dk-1983/4VRS-Display/assets/media/server-rack/README.txt

4VRS personal server rack animation.

4vrs-server-rack-240x320.gif: 240x320, 24 frames, 180ms encoded frame delay,
69318 bytes, infinite loop. Only tiny decorative front-panel LEDs animate;
rack, cables, title and flat background remain fixed. No live telemetry is
represented by this artwork. At most 15 display rows change between frames.
Rebuild with Pillow: python tools/package_rack_animation.py

Static artwork generated with built-in image_gen from the user's server rack
photograph. Prompt: isolate the actual silver cabinet, preserve patch cables,
panels, four compact servers and APC UPS arrangement; remove room, brick wall,
radiator and open glass door; straighten front view; solid dark navy background;
add metallic cyan 4VRS title above; no new equipment or extra text.
rack-original.png preserves generated source; rack-preview.png is first frame.
