dk-1983/4VRS-Display/hardware/schematic/4vrs-display-schematic-A2.pdf

4VRS DISPLAY | Power, controller and display

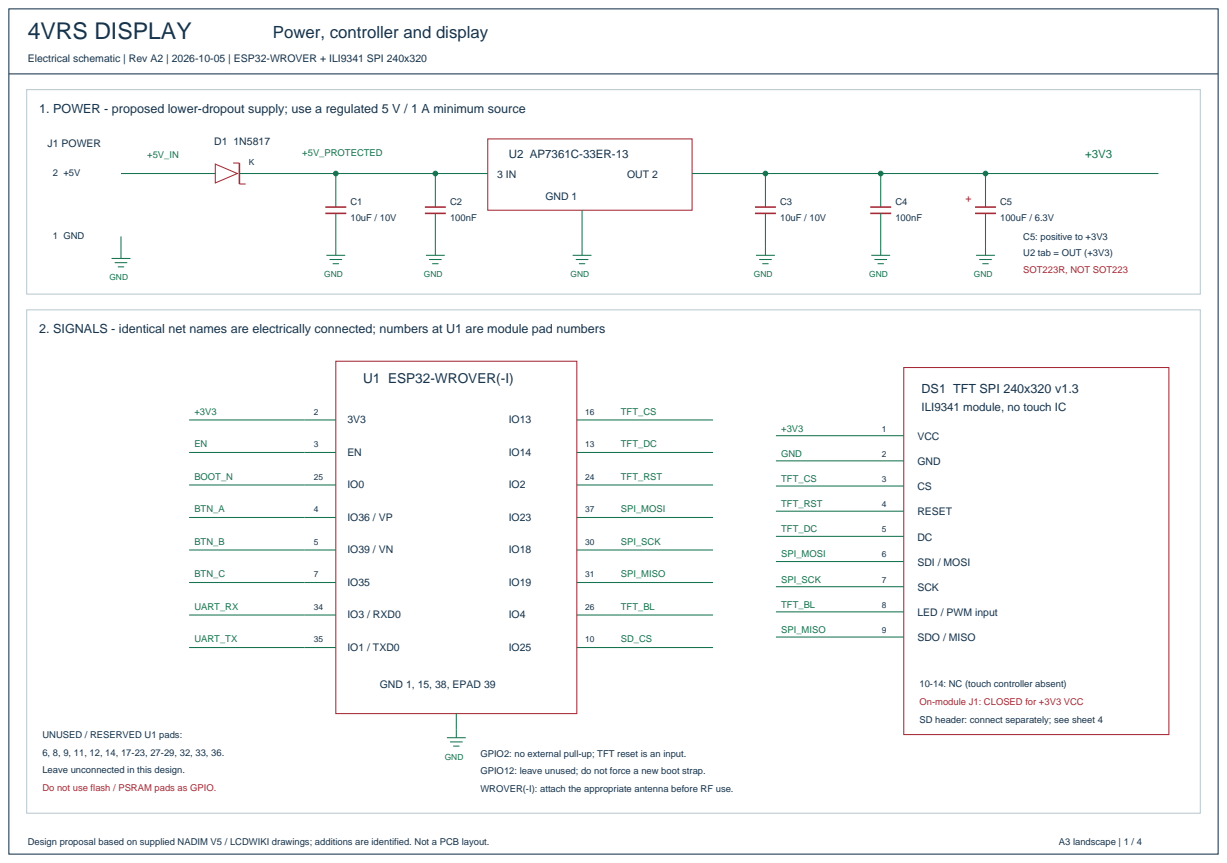
[picture p2: page 1]

Electrical schematic | Rev A2 | 2026-10-05 | ESP32-WROVER + ILI9341 SPI 240x320

1. POWER - proposed lower-dropout supply; use a regulated 5 V / 1 A minimum source

2. SIGNALS - identical net names are electrically connected; numbers at U1 are module pad numbers

DS1 TFT SPI 240x320 v1.3
ILI9341 module, no touch IC

10-14: NC (touch controller absent)
On-module J1: CLOSED for +3V3 VCC
SD header: connect separately; see sheet 4

UNUSED / RESERVED U1 pads:
Leave unconnected in this design.
Do not use flash / PSRAM pads as GPIO.

GPIO2: no external pull-up; TFT reset is an input.
GPIO12: leave unused; do not force a new boot strap.
WROVER(-I): attach the appropriate antenna before RF use.

4VRS DISPLAY | Reset, service connector and backlight

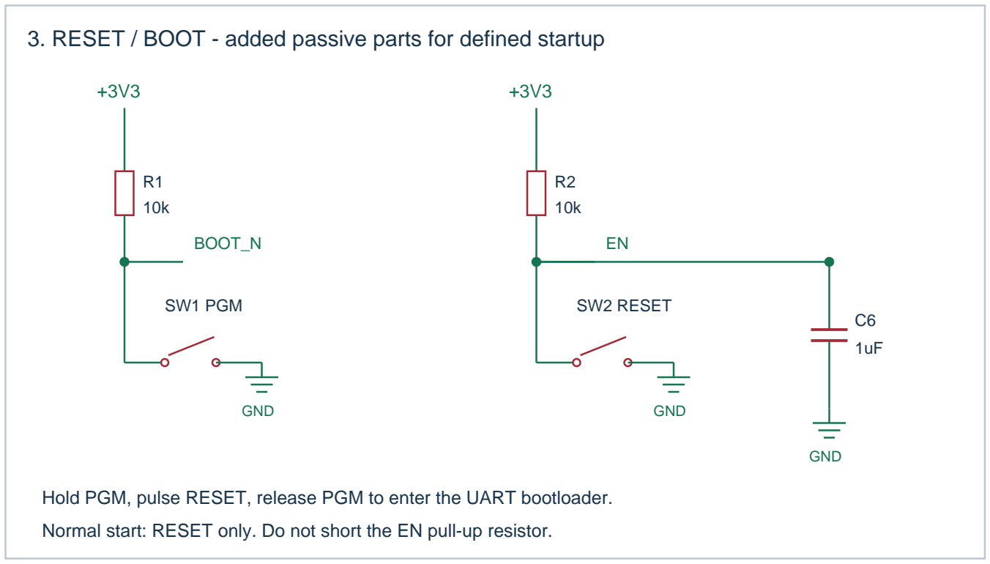
[picture p3: figure]
BOOT_N; SW1 PGM; GND; SW2 RESET

Design proposal based on supplied NADIM V5 / LCDWIKI drawings; additions are identified. Not a PCB layout. | A3 landscape | 2 / 4

### 3. RESET / BOOT - added passive parts for defined startup

Hold PGM, pulse RESET, release PGM to enter the UART bootloader. Normal start: RESET only. Do not short the EN pull-up resistor.

### 4. UART SERVICE - 3.3 V logic, manual reset

### J2 / P10 UART

1

GND
Adapter GND

2

UART_RX
From adapter TX output

3

UART_TX
To adapter RX input

Power the device through J1; do not join two supply outputs. Signal direction is authoritative: adapter connector labels may vary. UART log: 115200 baud. GPIO1 = ESP TX; GPIO3 = ESP RX.

### 5. OUR MODULE - direct GPIO4 to display LED pin

## U1 ESP32

GPIO4 / pad 26

## DS1 ILI9341

8 LED / PWM

TFT_BL

Actual wiring: GPIO4 connects directly to DS1 pin 8 (LED). No external transistor or series resistor in this connection. Module internal backlight circuitry is not expanded here. Firmware PWM: 5 kHz / 10 bit. HIGH enables backlight.

Optional R3: PWM low at reset.

R3
100k
TFT_BL

GND

### 6. ALTERNATIVE ONLY - display with separate LEDA / LEDK

GPIO4

R20
1k

GND

Q20 MMBT2222A

B=1, E=2, C=3

R21
see calculation
LEDK

R22
100k

GND
LEDA -> rated supply; LEDK -> R21 -> Q20 collector. Example: one 3.0 V LED string, 3.3 V supply, 10 mA target. R21 >= (3.3 - 3.0 - 0.1) / 0.010 = 20 ohm; choose 22 ohm. Recalculate for actual Vf, current and supply tolerances. Parallel strings need individual limiting or a LED driver.
Not for our DS1 LED input. Do not connect both circuits.

R20 limits GPIO/base current; the original drawing omitted it.

4VRS DISPLAY | Assembly notes, options and component list

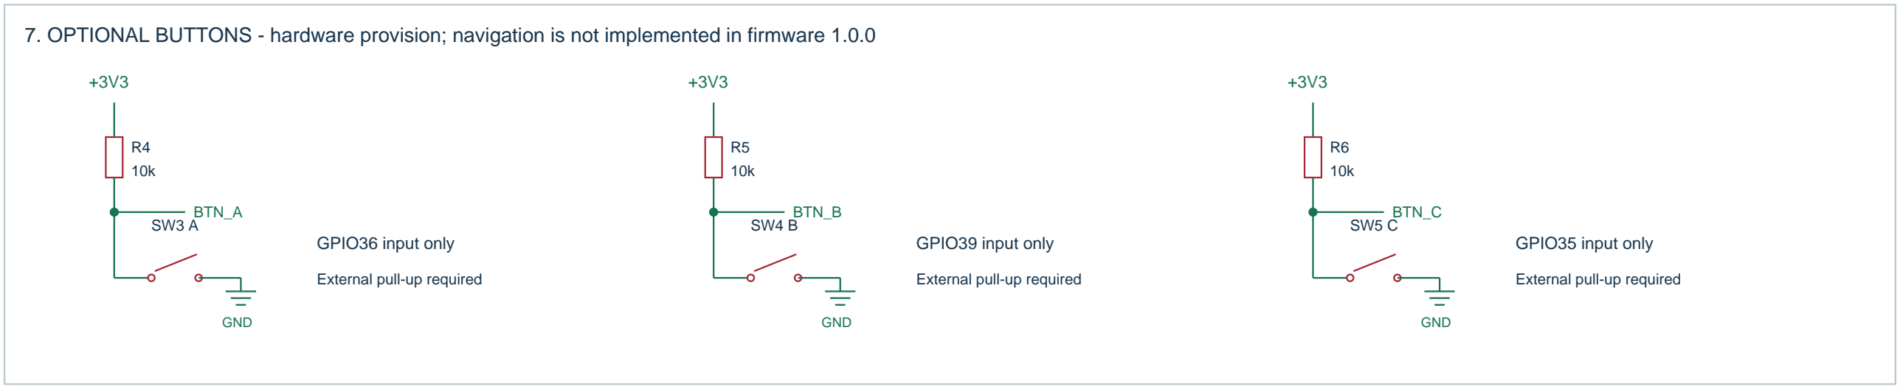
[picture p4: figure]
BTN_A SW3 A; GND; GPIO36 input only; External pull-up required; BTN_B SW4 B; GPIO39 input only; BTN_C SW5 C; GPIO35 input only

Design proposal based on supplied NADIM V5 / LCDWIKI drawings; additions are identified. Not a PCB layout. | A3 landscape | 3 / 4

### 7. OPTIONAL BUTTONS - hardware provision; navigation is not implemented in firmware 1.0.0

### 8. MAIN ASSEMBLY BOM

U1 | ESP32-WROVER(-I), PSRAM, module
U2 | AP7361C-33ER-13, 3.3 V, SOT223R
D1 | 1N5817, series reverse-polarity diode
J1 / J2 | 2-pin power / 3-pin UART connector
DS1 | TFT SPI ILI9341 240x320, LED logic input
C1 / C3 | 10uF X7R, 10 V; effective C >= 4.7uF
C2 / C4 | 100nF X7R, 10 V or higher
C5 | 100uF electrolytic, >= 6.3 V
C6 | 1uF X7R, >= 6.3 V
R1 / R2 | 10k, 1%, 0.1 W or higher
R3 | 100k, 1%, optional PWM pull-down
SW1 / SW2 | Normally-open momentary PGM / RESET
R4-R6 / SW3-SW5 | Optional: 10k / normally-open buttons

Q20 / R20-R22 belong only to the alternative, not the main BOM.

### 9. BUILD CONDITIONS AND REFERENCES

U2 is a proposed change from the original L1117-33 supply. Check the exact SOT223R package: 1=GND, 2/tab=OUT, 3=IN. Ordinary SOT223 AP7361C has a different pinout.
Place C1/C2 close to U2 IN; C3 close to U2 OUT.
Place C4/C5 close to U1 power pins with a short ground return. Allow at least 500 mA for ESP32 plus LCD/backlight current. LDO heat: P=(Vin-3.3)*I; 4.7 V at 0.5 A gives about 0.7 W. Provide copper area and check temperature inside the enclosure. For sustained high load, use a qualified 3.3 V buck supply.
DS1 VCC=3.3 V: close its supply jumper J1 (0R bypass).
If changing DS1 VCC to 5 V, open its J1 first.
Touch pins are NC; SD uses SPI + GPIO25 (sheet 4).
GPIO numbers are not ESP32 chip QFN pad numbers.
No ERC/SPICE or new PCB hardware validation has been run. Confirm supply, startup and current on the assembled hardware.

Manufacturer documentation (clickable in PDF):

LCDWIKI MSP2402: module schematic and manual (https://www.lcdwiki.com/2.4inch_SPI_Module_ILI9341_SKU:MSP2402) Espressif: WROVER module / hardware design guidelines (https://docs.espressif.com/projects/esp-hardware-design-guidelines/en/latest/esp32/schematic-checklist.html) Diodes: AP7361C datasheet; original 1117: see TI datasheet (https://www.diodes.com/datasheet/download/AP7361C.pdf)

4VRS DISPLAY | Shared SPI bus and SD memory card

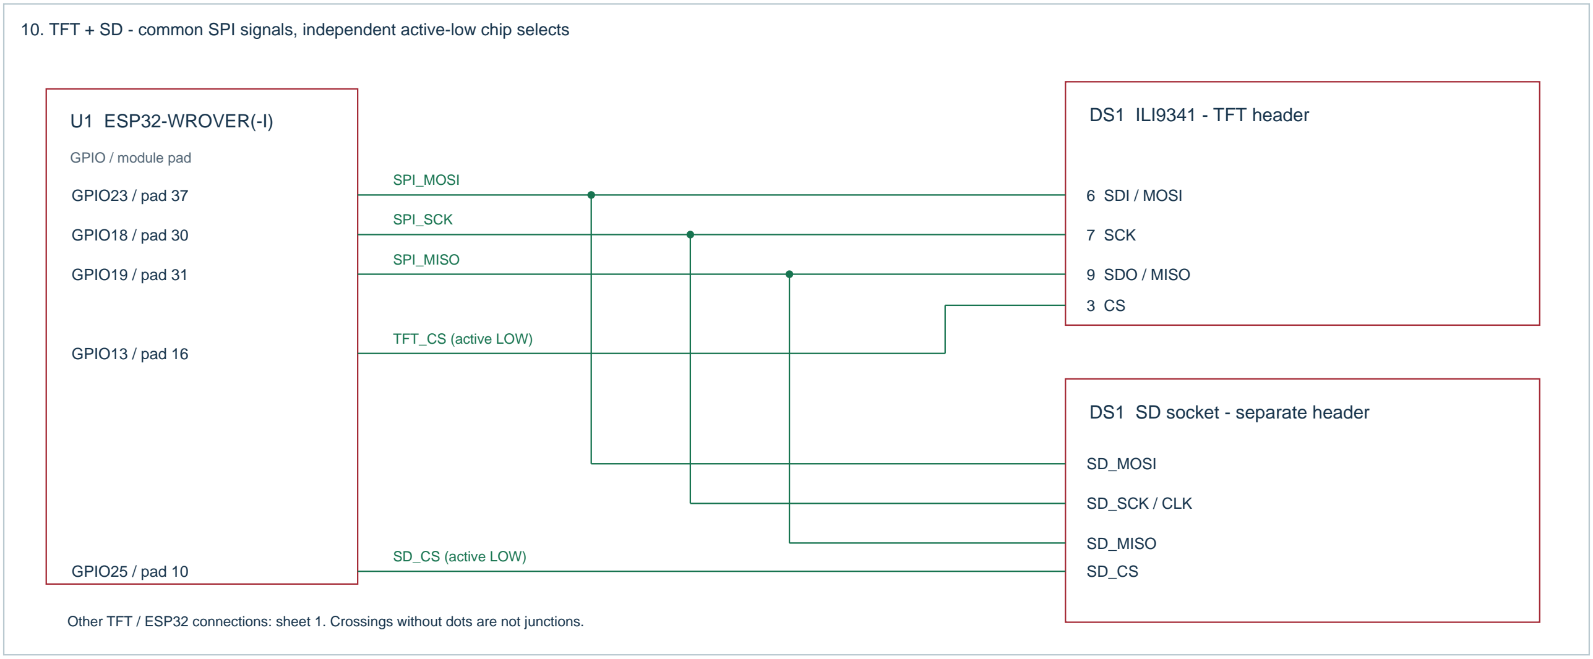
[picture p5: figure]
U1 ESP32-WROVER(-I); GPIO / module pad; DS1 ILI9341 - TFT header; DS1 SD socket - separate header; GPIO23 / pad 37; SPI_MOSI; 6 SDI / MOSI; SD_MOSI; GPIO18 / pad 30; SPI_SCK; 7 SCK; SD_SCK / CLK; GPIO19 / pad 31; SPI_MISO; 9 SDO / MISO; SD_MISO; GPIO13 / pad 16; TFT_CS (active LOW); GPIO25 / pad 10; SD_CS (active LOW)

Design proposal based on supplied NADIM V5 / LCDWIKI drawings; additions are identified. Not a PCB layout. | A3 landscape | 4 / 4

### 10. TFT + SD - common SPI signals, independent active-low chip selects

Other TFT / ESP32 connections: sheet 1. Crossings without dots are not junctions.

### 11. ASSEMBLY - existing SD socket on our LCDWIKI display module

Wire all FOUR SD header signals; the module does not internally connect them to the TFT SPI header. SD header contacts are identified by their silkscreen names; no unverified header pin order is implied. TFT_CS = GPIO13. SD_CS = GPIO25 (U1 module pad 10). Do not connect the two CS signals together. SD socket power and ground are internal to DS1; retain the module VCC/GND connection from sheet 1. All logic is 3.3 V. Keep SPI leads short. MISO is required for SD even without TFT readback diagnostics. Firmware 1.0.0 uses a shared SPI bus, MISO pull-up and separate CS handling; SD starts at 1 MHz. Use a FAT32 card; 16 GB microSD with a full-size SD adapter has been tested. No automatic formatting. This sheet shows the existing module socket, not a wiring diagram for an arbitrary bare SD socket.
