dk-1983/4VRS-Display/docs/README.md

# Документация 4VRS Display

- [Первый запуск и web-настройки](user-guide.md)
- [Оборудование и диагностика дисплея](hardware.md)
- [Home Assistant и карточки](home-assistant.md)
- [Обновление прошивки](updates.md)
- [Сборка и тестирование](development.md)
- [План развития](plan.md)
- [MQTT-протокол](../protocol/README.md)

Эти инструкции описывают firmware 1.0.0 и интеграцию Home Assistant 0.4.3.
