dk-1983/4VRS-Display/home_assistant/README.md

# Интеграция Home Assistant 0.4.3

[Установка, сопряжение и выбор сущностей](../docs/home-assistant.md).

Исходный компонент: `custom_components/fourvrs_display`. При обновлении сохраняйте
существующее сопряжение и перезапускайте HA после замены файлов.
