dk-1983/4VRS-Display/protocol/examples/README.md

# Примеры MQTT

JSON-файлы содержат вымышленные ключи и идентификаторы для проверки протокола.
Используйте собственный ключ и актуальную сессию при работе с устройством.
