dk-1983/4VRS-Display/protocol/schemas/README.md

# JSON Schema

Схемы описывают форматы сообщений MQTT. Дополнительные ограничения UTF-8 в байтах
помечены `x-maxUtf8Bytes` и проверяются реализациями отдельно от JSON Schema.
