dk-1983/4VRS-Display/assets/media/tux/README.txt

Tux / intel inside decorative animation for 4VRS Display.

tux-intel-inside-240x320.gif: 240x320, looping, 24348 bytes.
Static body and flat dark background; small blinking-eye and badge-glint layers.
Rebuild with Pillow: python tools/package_tux_animation.py

Static artwork generated with built-in image_gen. Prompt: friendly recognizable
Tux penguin, front-facing, white belly, yellow beak/feet, clear oval eyes;
cyan classic oval badge reading exactly "intel inside" above; solid dark navy
background, no other text or objects, composition suitable for a small display.
Original and first-frame preview are preserved alongside the GIF.

Third-party names and marks belong to their respective owners. Decorative
artwork does not imply endorsement or describe the ESP32's processor vendor.
The project MIT license does not grant rights to third-party trademarks.
