dk-1983/4VRS-Display/docs/plan.md

# Roadmap / План развития

Firmware 1.0.0 includes MQTT room cards, web settings, signed OTA, FAT32 SD photo/GIF playback, browser media uploads and per-file slideshow timing. Home Assistant integration 0.4.3 supports optional entities, brightness and MAC diagnostics.

Next steps: HA-side media management, richer playlists, local sensors and physical-button navigation. Video/audio are not implemented. Scope and hardware support will be agreed before development.

В 1.0.0 реализованы MQTT-карточки по помещениям, web-настройки, подписанные OTA, фото/GIF с FAT32 SD, загрузка из браузера и индивидуальное время файлов в слайд-шоу. Интеграция HA 0.4.3 поддерживает сопряжение без сущностей, яркость и диагностику MAC.

Далее: управление медиа из HA, расширенные плейлисты, локальные датчики и физические кнопки. Видео и звук не реализованы. Объём работы и поддерживаемое оборудование согласуются перед разработкой.
