dk-1983/4VRS-Display/assets/demo-240x320.bmp

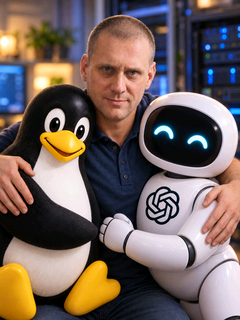
assets/demo-240x320.bmp
