dk-1983/4VRS-Display/assets/demo-source.png

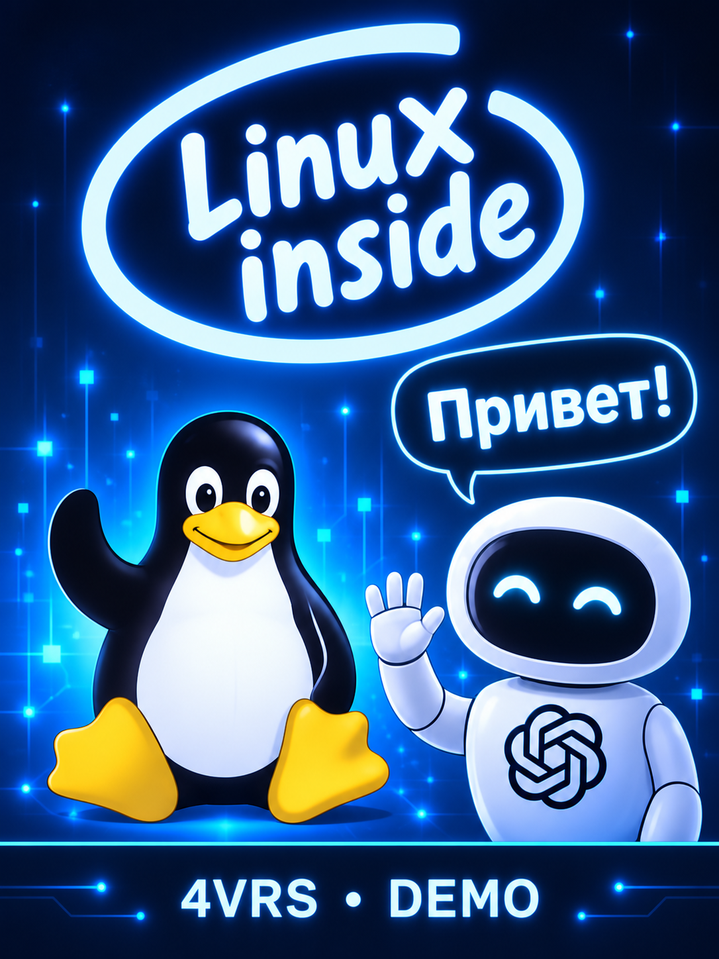
assets/demo-source.png
