dk-1983/4VRS-Display/assets/media/bolid/bolid-240x320.gif

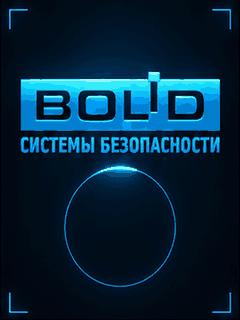
assets/media/bolid/bolid-240x320.gif
