dk-1983/4VRS-Display/assets/media/bolid/bolid-flat-original.png

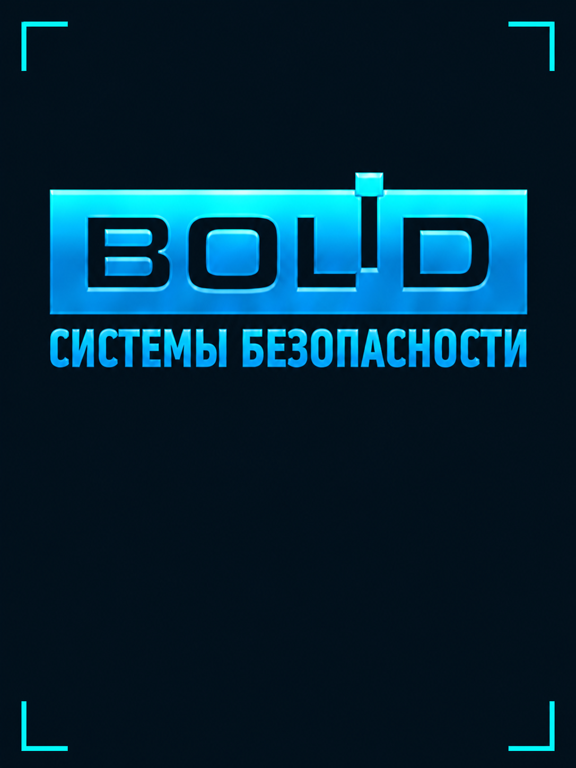
assets/media/bolid/bolid-flat-original.png
