dk-1983/4VRS-Display/assets/media/bolid/bolid-frames-original.png

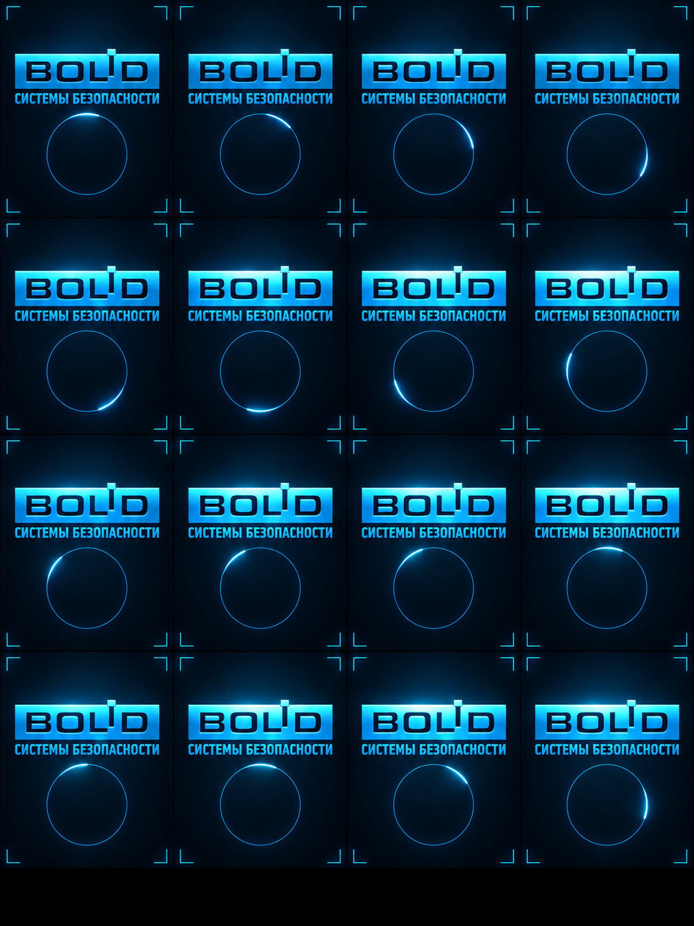
assets/media/bolid/bolid-frames-original.png
