dk-1983/4VRS-Display/assets/media/bolid/bolid-s2000-kpb-240x320.gif

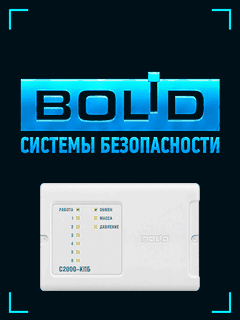
assets/media/bolid/bolid-s2000-kpb-240x320.gif
