dk-1983/4VRS-Display/assets/media/bolid/bolid-static-original.png

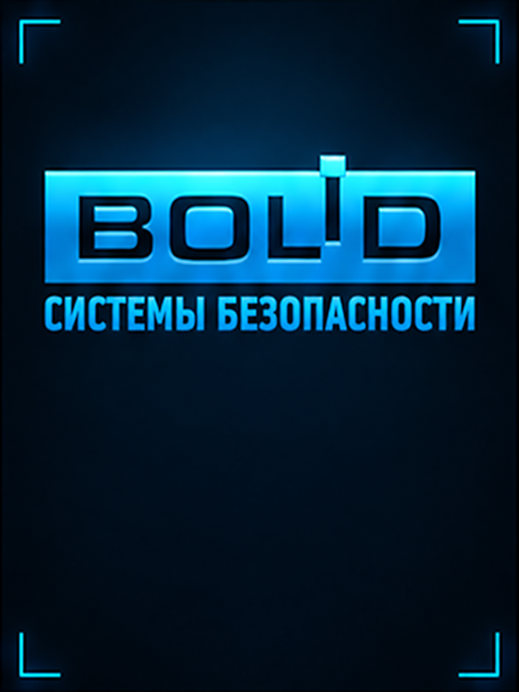
assets/media/bolid/bolid-static-original.png
