dk-1983/4VRS-Display/assets/media/bolid/s2000-kpb-cutout.png

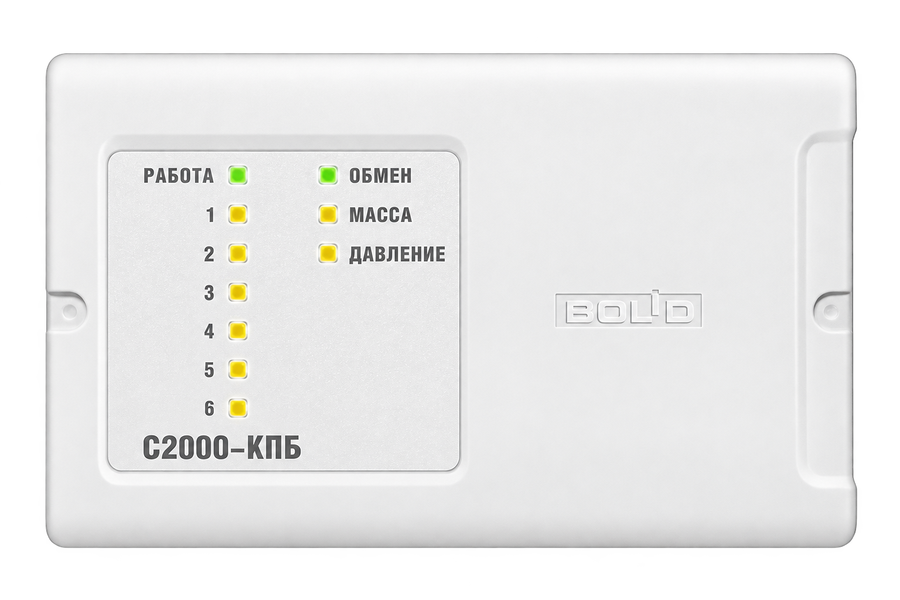
assets/media/bolid/s2000-kpb-cutout.png
