dk-1983/4VRS-Display/assets/media/companion/companion-240x320.gif

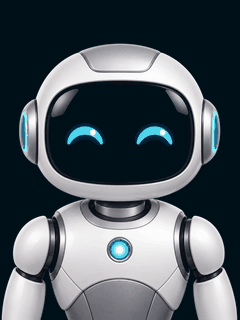
assets/media/companion/companion-240x320.gif
