dk-1983/4VRS-Display/assets/media/server-rack/4vrs-server-rack-240x320.gif

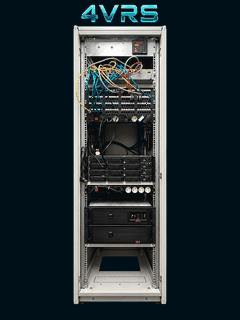
assets/media/server-rack/4vrs-server-rack-240x320.gif
