dk-1983/4VRS-Display/assets/media/tux/tux-intel-inside-240x320.gif

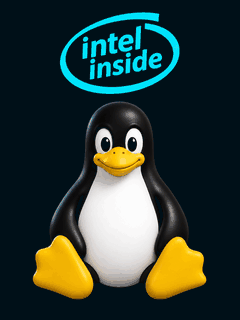
assets/media/tux/tux-intel-inside-240x320.gif
