dk-1983/4VRS-Display/home_assistant/tests/README.md

# Тесты интеграции

Запуск из корня проекта:

```sh
python -m unittest discover -s home_assistant/tests -v
```

Проверяются сопряжение, состояния, помещения, выбор сущностей и политика обновлений.
