dk-1983/4VRS-Display/assets/test/4vrs-test.gif

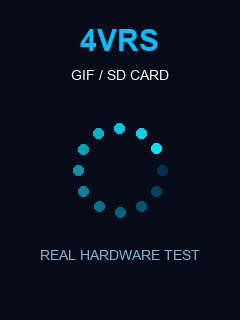
assets/test/4vrs-test.gif
