dk-1983/4VRS-Display/firmware/rack_bootstrap/MqttProtocol.h

#pragma once
#include <Arduino.h>
#include <cJSON.h>
#include <math.h>

namespace RackMqtt {
constexpr size_t MAX_PAYLOAD = 15360;
constexpr unsigned MAX_CARDS = 20;
struct Card { char id[97]{}, name[97]{}, kind[17]{}, state[97]{}, unit[17]{}, icon[17]{}, area[49]{}, areaIcon[17]{}; bool alert=false, hasArea=false; };
struct Snapshot { Card cards[MAX_CARDS]; unsigned count=0; uint32_t seq=0, ttl=90, received=0; bool valid=false; };

inline bool textField(const cJSON *obj, const char *key, char *out, size_t size, bool empty=false) {
  const cJSON *v=cJSON_GetObjectItemCaseSensitive(obj,key);
  if(!cJSON_IsString(v) || !v->valuestring) return false;
  const char *s=v->valuestring; size_t n=strlen(s);
  if(n>=size || (!empty && !n)) return false;
  // Reject controls and malformed UTF-8 before passing text to the renderer.
  for(size_t i=0;i<n;) {
    uint8_t a=(uint8_t)s[i++];
    if(a<32 || a==127) return false;
    if(a<128) continue;
    unsigned more; uint32_t cp, minimum;
    if(a>=0xc2 && a<=0xdf) {more=1;cp=a&31;minimum=0x80;}
    else if(a>=0xe0 && a<=0xef) {more=2;cp=a&15;minimum=0x800;}
    else if(a>=0xf0 && a<=0xf4) {more=3;cp=a&7;minimum=0x10000;}
    else return false;
    if(i+more>n) return false;
    while(more--) {uint8_t b=(uint8_t)s[i++];if((b&0xc0)!=0x80)return false;cp=(cp<<6)|(b&63);}
    if(cp<minimum || cp>0x10ffff || (cp>=0xd800 && cp<=0xdfff)) return false;
  }
  memcpy(out,s,n+1); return true;
}
inline bool numberField(const cJSON *obj,const char *key,uint32_t &out,uint32_t lo,uint32_t hi) {
  const cJSON *v=cJSON_GetObjectItemCaseSensitive(obj,key);
  if(!cJSON_IsNumber(v) || !isfinite(v->valuedouble) || v->valuedouble<lo || v->valuedouble>hi || floor(v->valuedouble)!=v->valuedouble) return false;
  out=(uint32_t)v->valuedouble;return true;
}
inline bool uniqueKeys(const cJSON *obj,unsigned depth=0) {
  if(depth>8) return false;
  for(const cJSON *a=obj->child;a;a=a->next) {
    if(cJSON_IsObject(obj)) for(const cJSON *b=a->next;b;b=b->next)
      if(a->string && b->string && !strcmp(a->string,b->string)) return false;
    if((cJSON_IsObject(a)||cJSON_IsArray(a))&&!uniqueKeys(a,depth+1)) return false;
  } return true;
}
inline cJSON *parse(const char *data,size_t length) {
  // cJSON accepts embedded escaped NULs; reject them to prevent truncated keys/text.
  if(!length || length>MAX_PAYLOAD || memchr(data,0,length)) return nullptr;
  for(size_t i=0;i+5<length;i++) if(data[i]=='\\' && !memcmp(data+i+1,"u0000",5)) return nullptr;
  unsigned depth=0;bool quoted=false,escaped=false;
  for(size_t i=0;i<length;i++) {char c=data[i];if(quoted){if(escaped)escaped=false;else if(c=='\\')escaped=true;else if(c=='"')quoted=false;}
    else if(c=='"')quoted=true;else if(c=='{'||c=='['){if(++depth>8)return nullptr;}else if(c=='}'||c==']'){if(!depth)return nullptr;--depth;}}
  if(depth||quoted)return nullptr;
  const char *end=nullptr; cJSON *root=cJSON_ParseWithLengthOpts(data,length,&end,false);
  if(!root)return nullptr;
  while(end<data+length && (*end==' '||*end=='\r'||*end=='\n'||*end=='\t'))++end;
  if(end!=data+length || !cJSON_IsObject(root) || !uniqueKeys(root)){cJSON_Delete(root);return nullptr;}
  return root;
}
inline bool allowedKeys(const cJSON *obj,const char *const *keys,size_t count) {
  for(const cJSON *v=obj->child;v;v=v->next){bool found=false;for(size_t i=0;i<count;i++)if(v->string&&!strcmp(v->string,keys[i]))found=true;if(!found)return false;}return true;
}
inline const char *decodeSnapshot(const cJSON *root,const char *session,uint32_t lastSeq,Snapshot &next) {
  const char *const keys[]={"schema","key","session","seq","ttl_s","cards"};
  if(!allowedKeys(root,keys,6))return "unknown_field";
  uint32_t schema; char incoming[33];
  if(!numberField(root,"schema",schema,1,1))return "schema";
  if(!textField(root,"session",incoming,sizeof(incoming))||strcmp(session,incoming))return "session";
  if(!numberField(root,"seq",next.seq,1,0xffffffffU)||next.seq<=lastSeq)return "sequence";
  if(!numberField(root,"ttl_s",next.ttl,30,300))return "ttl";
  const cJSON *cards=cJSON_GetObjectItemCaseSensitive(root,"cards");
  if(!cJSON_IsArray(cards))return "cards";
  int count=cJSON_GetArraySize(cards);if(count<0||count>MAX_CARDS)return "card_count";
  for(int i=0;i<count;i++) {
    const cJSON *v=cJSON_GetArrayItem(cards,i);const char *const ck[]={"id","name","kind","state","unit","icon","alert","area","area_icon"};
    if(!cJSON_IsObject(v)||!allowedKeys(v,ck,9))return "card";
    Card &c=next.cards[i];
    if(!textField(v,"id",c.id,sizeof(c.id))||!textField(v,"name",c.name,sizeof(c.name))||!textField(v,"kind",c.kind,sizeof(c.kind))||!textField(v,"state",c.state,sizeof(c.state))||!textField(v,"unit",c.unit,sizeof(c.unit),true))return "card_text";
    if(cJSON_HasObjectItem(v,"area")) {
      if(!textField(v,"area",c.area,sizeof(c.area),true))return "area";
      c.hasArea=true;
    }
    if(cJSON_HasObjectItem(v,"area_icon")) {
      if(!c.hasArea||!textField(v,"area_icon",c.areaIcon,sizeof(c.areaIcon)))return "area_icon";
      const char *icons[]={"room","toilet","bathroom","kitchen","bedroom","living","garage","office","server","balcony","hall","garden","laundry","storage","kids"};
      bool known=false;for(const char *i:icons)if(!strcmp(c.areaIcon,i))known=true;
      if(!known)return "area_icon";
    }
    if(cJSON_HasObjectItem(v,"icon")) {
      if(!textField(v,"icon",c.icon,sizeof(c.icon)))return "icon";
      const char *icons[]={"air","battery","binary_sensor","button","camera","clock","door","event","fan","gas","group","humidity","image","leak","light","list","location","lock","media","money","motion","network","person","plug","power","pressure","remote","robot","ruler","sensor","settings","shield","smoke","sound","storage","sun","switch","temperature","text","update","valve","warning","water","weather","wind","window"};
      bool known=false;for(const char *i:icons)if(!strcmp(c.icon,i)){known=true;break;}
      if(!known)return "icon";
    }
    if(cJSON_HasObjectItem(v,"alert")){const cJSON *a=cJSON_GetObjectItemCaseSensitive(v,"alert");if(!cJSON_IsBool(a))return "alert";c.alert=cJSON_IsTrue(a);}
    for(const char *p=c.id;*p;p++)if(!((*p>='a'&&*p<='z')||(*p>='0'&&*p<='9')||*p=='_'||*p=='.'))return "entity_id";
    if(!strchr(c.id,'.'))return "entity_id";
    if(strcmp(c.kind,"fan")&&strcmp(c.kind,"light")&&strcmp(c.kind,"valve")&&strcmp(c.kind,"sensor")&&strcmp(c.kind,"binary_sensor")&&strcmp(c.kind,"switch")&&strcmp(c.kind,"text"))return "kind";
    for(int j=0;j<i;j++)if(!strcmp(next.cards[j].id,c.id))return "duplicate_entity";
  }
  next.count=count;next.valid=true;return nullptr;
}
}
