dk-1983/4VRS-Display/firmware/rack_bootstrap/UpdateTrust.h

#pragma once
static const char UPDATE_PUBLIC_KEY[] = R"KEY(-----BEGIN PUBLIC KEY-----
MFkwEwYHKoZIzj0CAQYIKoZIzj0DAQcDQgAE9PpxX9jvkpiPqAUe3N1g+ZxjWHlE
7ArprzonFSLyPWih6FXrnSCf6CHmrsrmMxV+tvzL7frYjyFZht7i5vLK1w==
-----END PUBLIC KEY-----
)KEY";
