dk-1983/4VRS-Display/firmware/rack_bootstrap/LocalSecrets.example.h

#pragma once
// Скопировать в LocalSecrets.h и заменить оба значения либо tools/init_secrets.py.
#define SETUP_PASSWORD "REPLACE-SETUP-PASSWORD"
#define OTA_PASSWORD "REPLACE-WITH-A-UNIQUE-OTA-PASSWORD"
