dk-1983/4VRS-Display/(commit log)

2026-09-13 chore: baseline working ESP32 display firmware 0.1.12-friends
2026-09-13 fix: prevent competing Digest challenges from looping web login
    [StableWebServer.h, rack_bootstrap.ino]
2026-09-13 feat: render temperature humidity and lighting icons on live cards
2026-09-13 feat: distinguish humidity percent and dry leak icons
    [MqttDisplay.h, MqttIcons.h, rack_bootstrap.ino]
2026-09-13 Pause stable channel while investigating device HTTPS failure
2026-09-13 Reduce TLS memory pressure and configure explicit GitHub trust roots
2026-09-13 Support GitHub Generation Y TLS chain with PSRAM-backed MQTT buffers
2026-09-13 Preserve signed CDN URLs and reset HTTP state across redirects
    [UpdateService.h]
2026-09-13 Stage signed 0.4.2 candidate for private updater validation
2026-09-13 Erase OTA flash sequentially and retain reset diagnostics
    [UpdateService.h]
2026-09-13 Stage signed 0.4.3 candidate with sequential flash erasure
2026-09-13 Add display schematic, UART wiring and manufacturer references
    [bom.csv]
2026-09-13 Document base circuit and optional extended A1 variant
2026-10-04 Release 1.0.0: SD photo frame, GIF slideshow and device settings
2026-10-05 Document shared SD SPI wiring and present approved schematic in README
